genmujmuj/robot-pk/inzynierka/rys1_robot_saperski_TALON.jpg

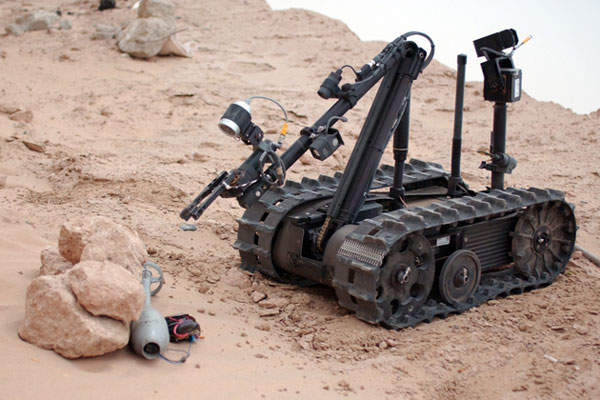
inzynierka/rys1_robot_saperski_TALON.jpg
