genmujmuj/robot-pk/inzynierka/screeny/front1.jpg

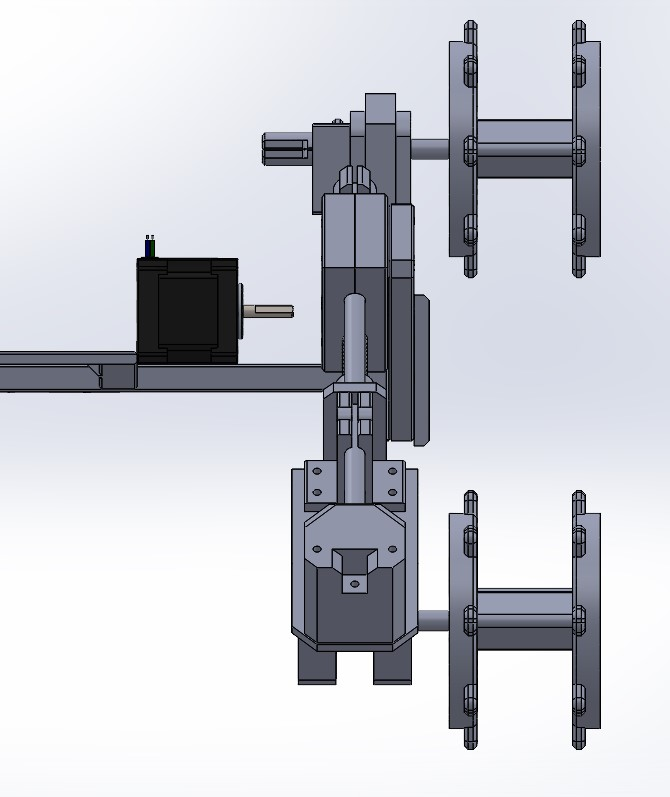
inzynierka/screeny/front1.jpg
