genmujmuj/robot-pk/inzynierka/ArduinoUNO-rys3.webp

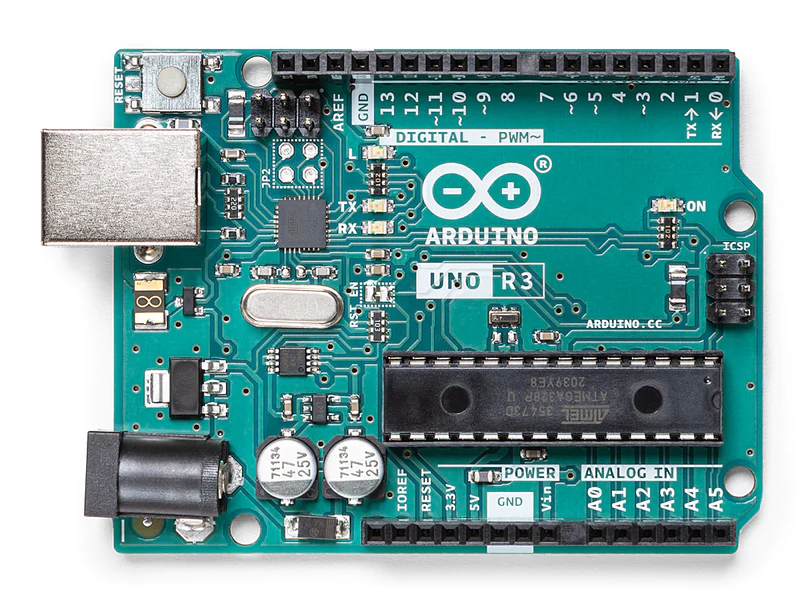
inzynierka/ArduinoUNO-rys3.webp
