genmujmuj/robot-pk/inzynierka/flysky_fs-ia6b.jpeg

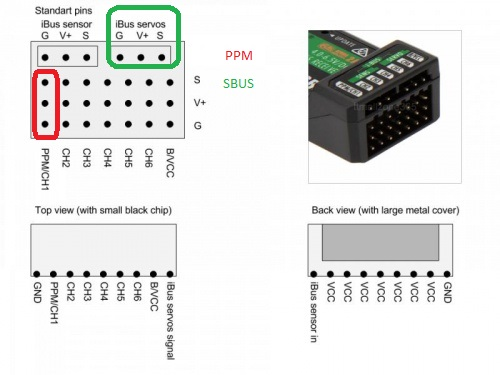
inzynierka/flysky_fs-ia6b.jpeg
