genmujmuj/robot-pk/inzynierka/pp_1.jpg

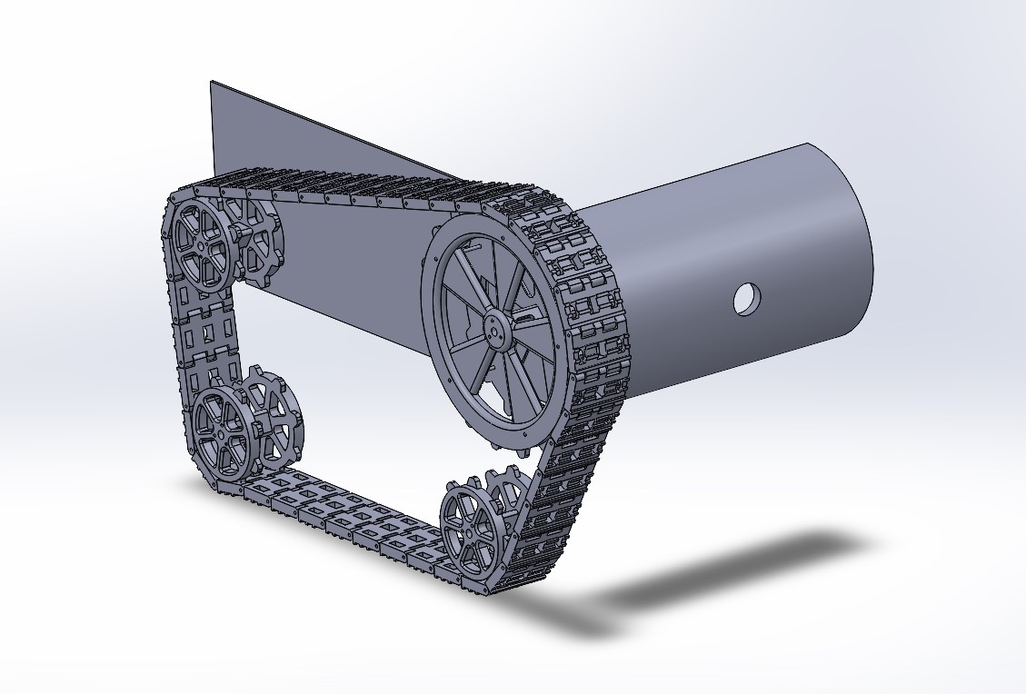
inzynierka/pp_1.jpg
