genmujmuj/robot-pk/inzynierka/pp_2.jpg

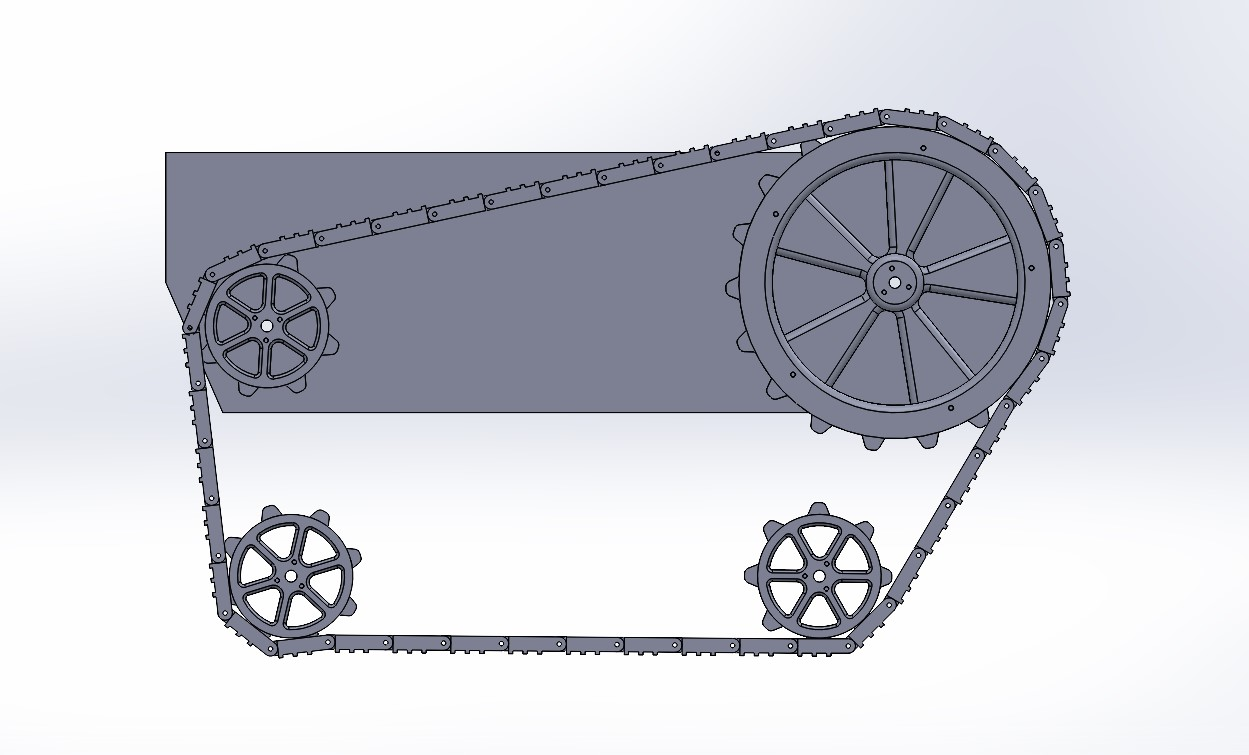
inzynierka/pp_2.jpg
