genmujmuj/robot-pk/inzynierka/rys_schemat_logiczny_układu.png

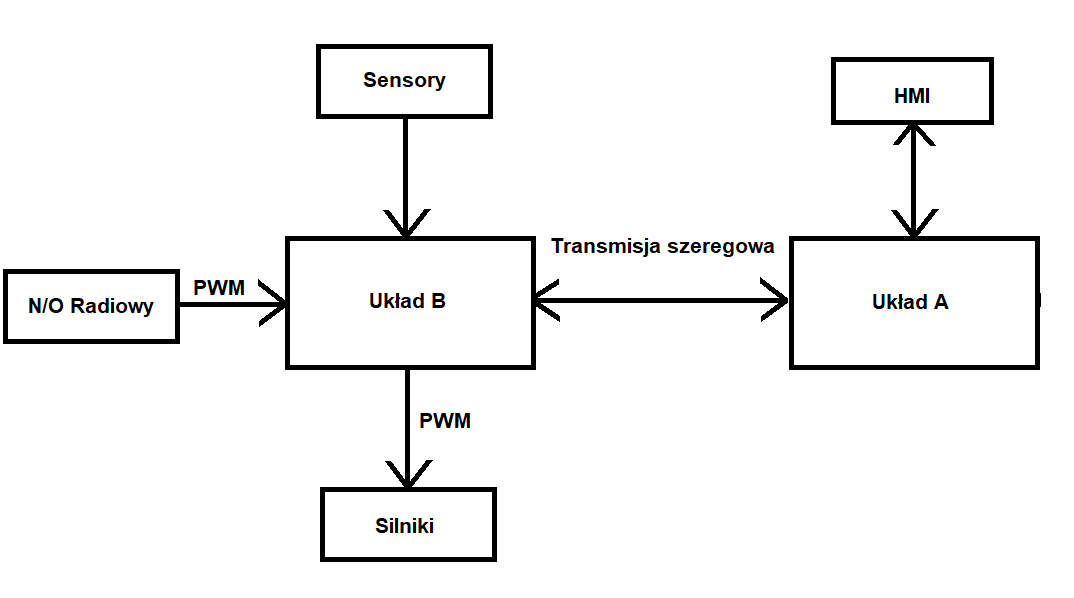
inzynierka/rys_schemat_logiczny_układu.png
