genmujmuj/robot-pk/inzynierka/screeny/bok1.jpg

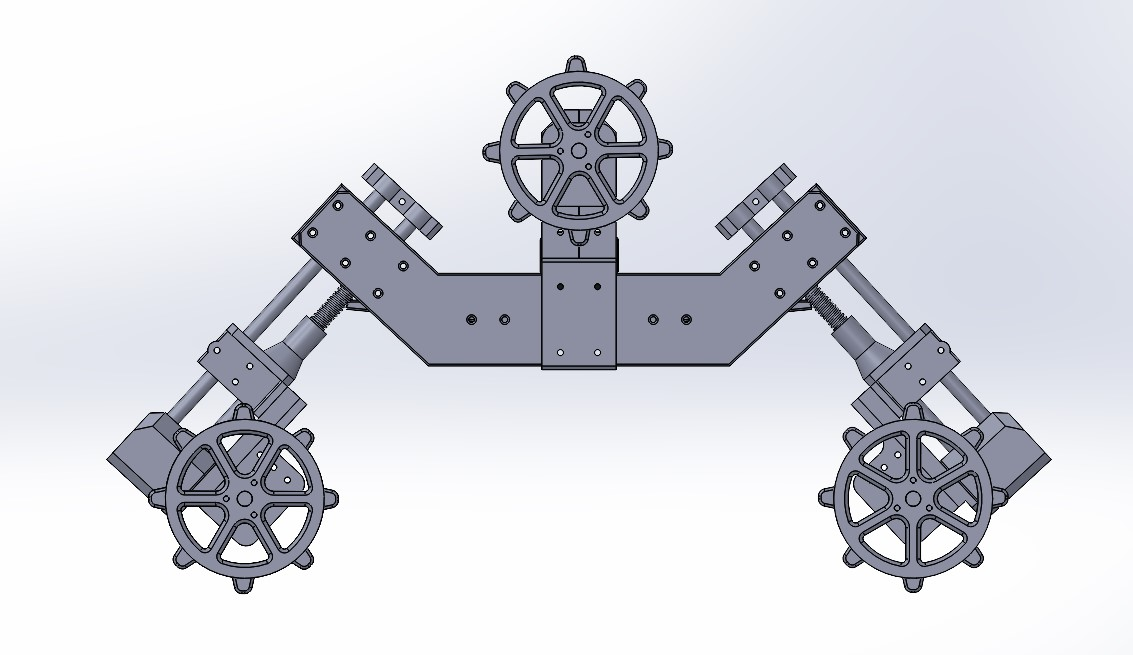
inzynierka/screeny/bok1.jpg
