genmujmuj/robot-pk/inzynierka/screeny/bok2.jpg

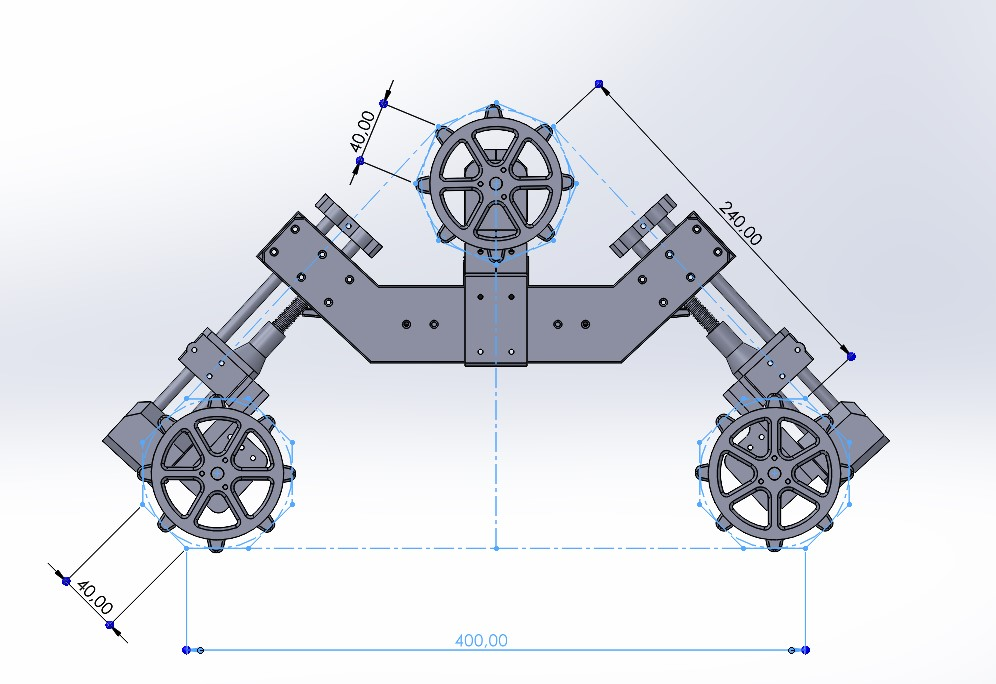
inzynierka/screeny/bok2.jpg
