genmujmuj/robot-pk/inzynierka/screeny/front2.jpg

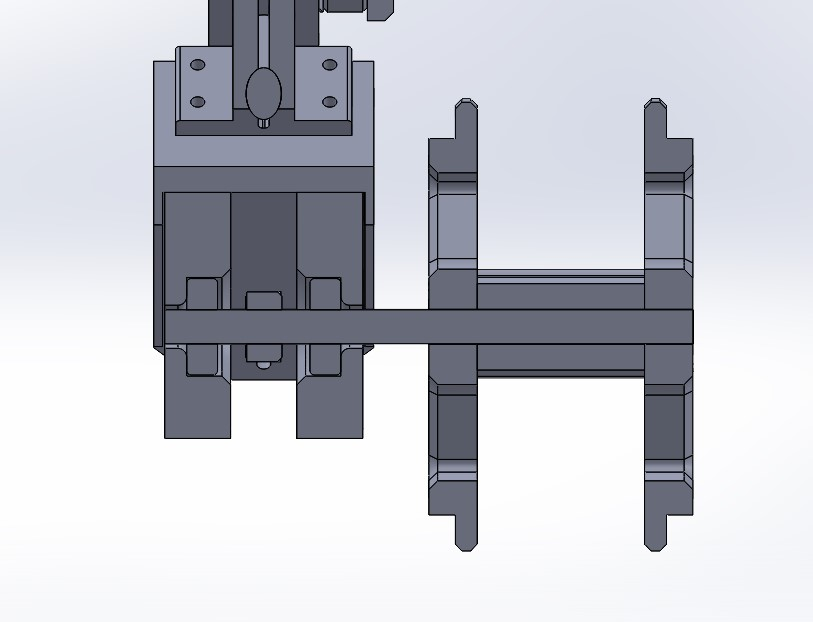
inzynierka/screeny/front2.jpg
