genmujmuj/robot-pk/inzynierka/screeny/góra1.jpg

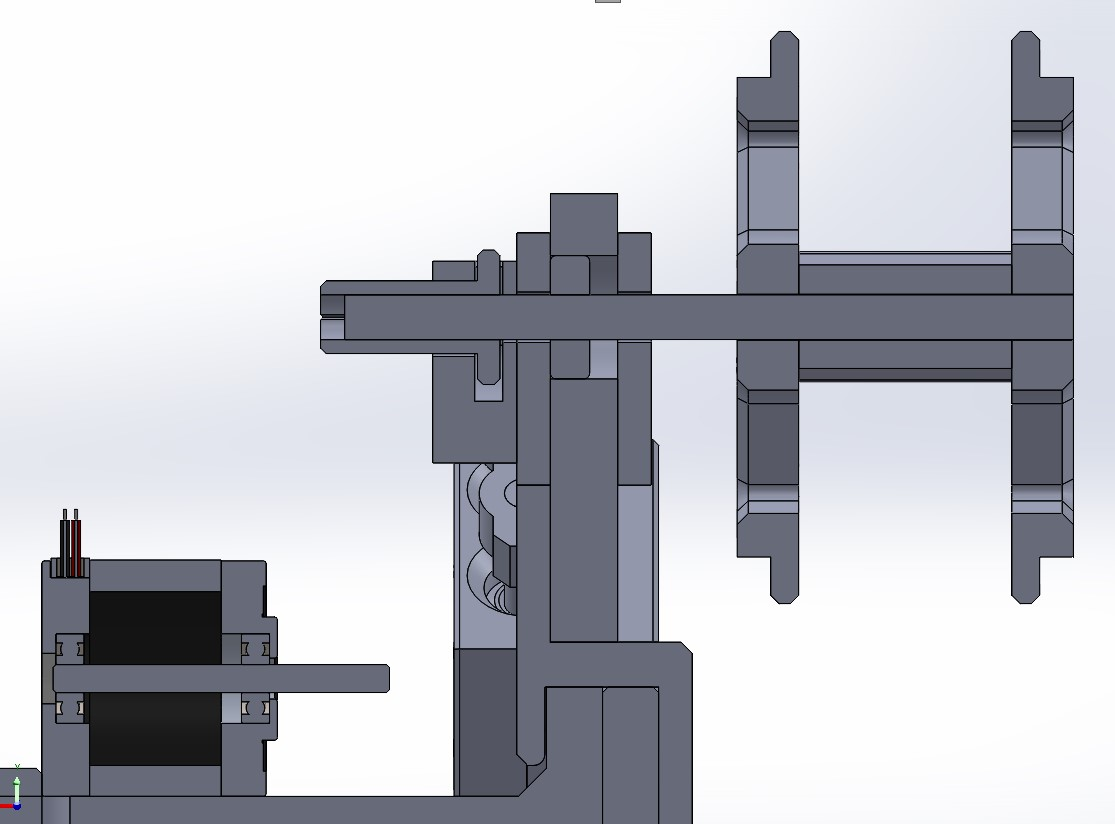
inzynierka/screeny/góra1.jpg
