genmujmuj/robot-pk/inzynierka/screeny/izo1.jpg

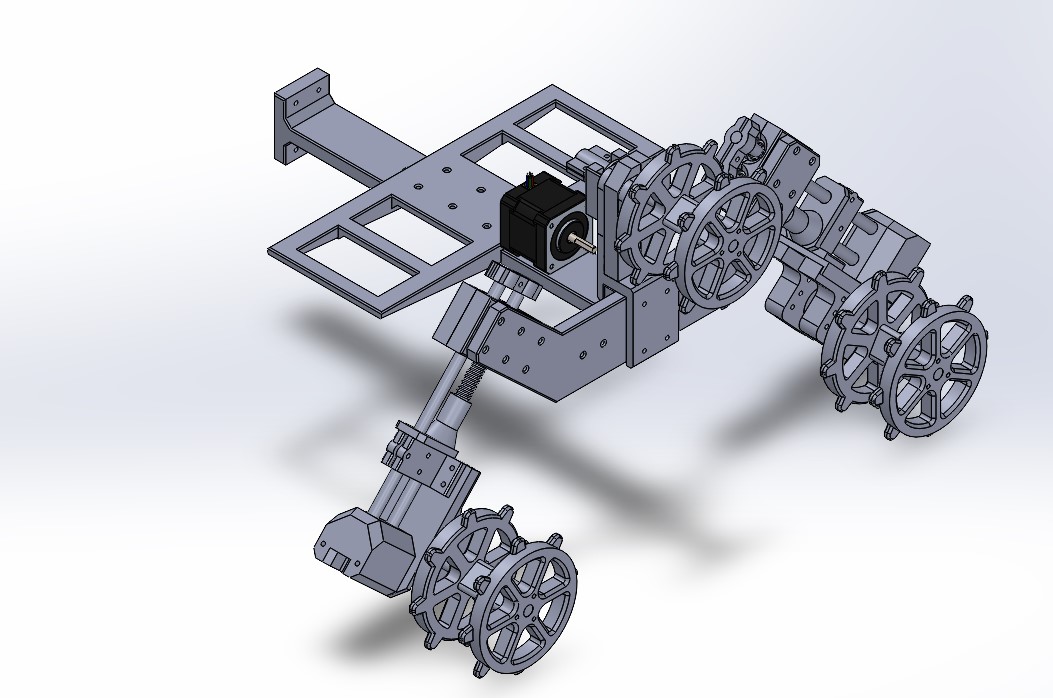
inzynierka/screeny/izo1.jpg
