genmujmuj/robot-pk/inzynierka/screeny/izo2.jpg

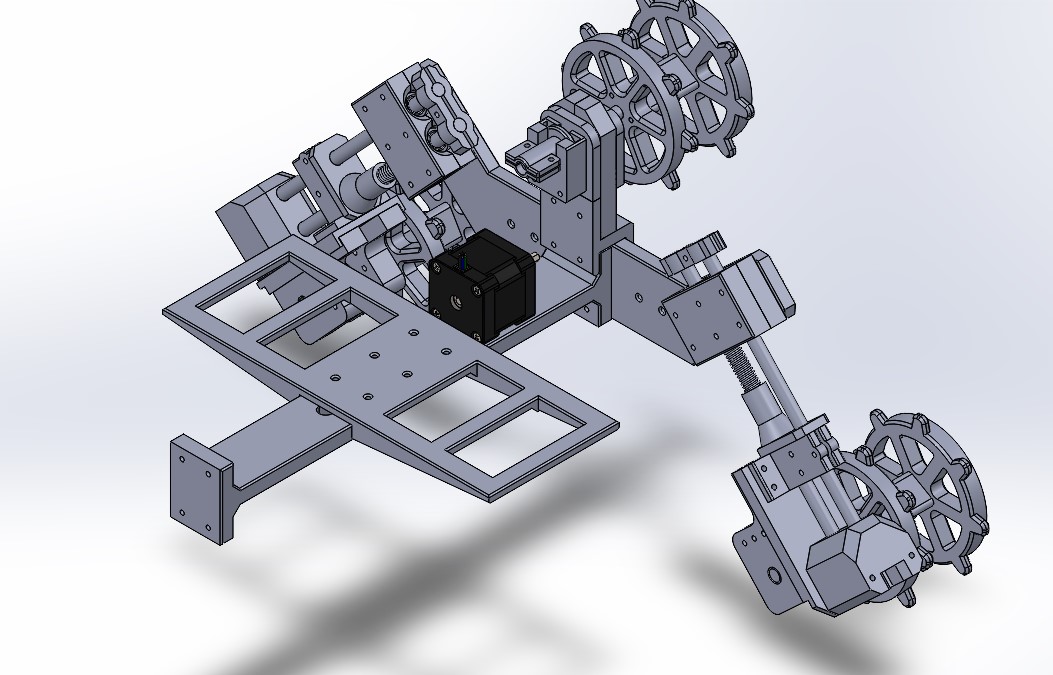
inzynierka/screeny/izo2.jpg
