genmujmuj/robot-pk/1.pdf

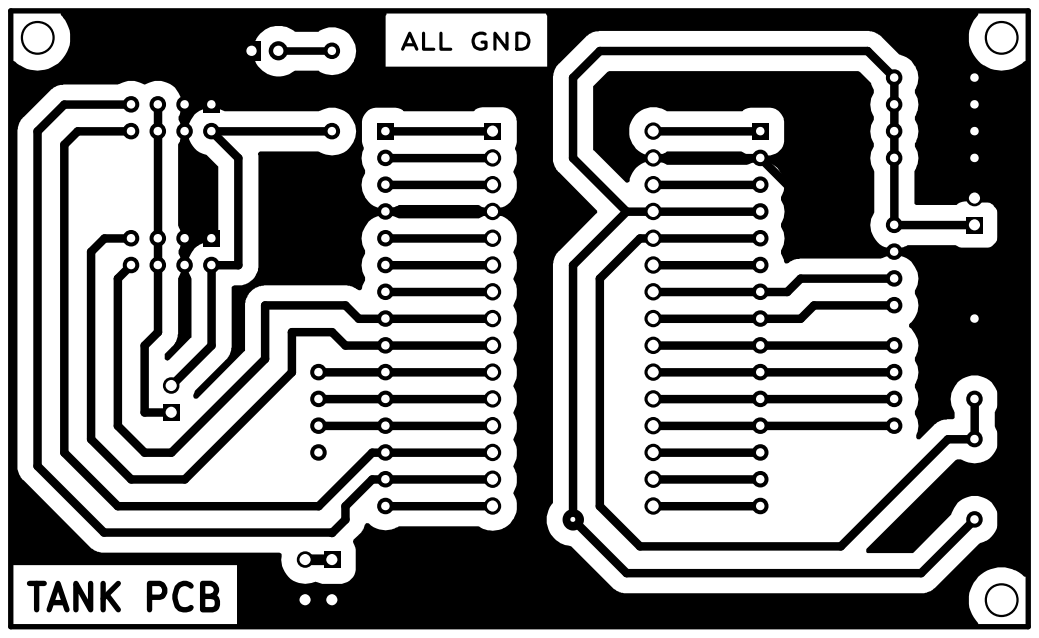
[picture p30: page 1]
