genmujmuj/robot-pk/2.pdf

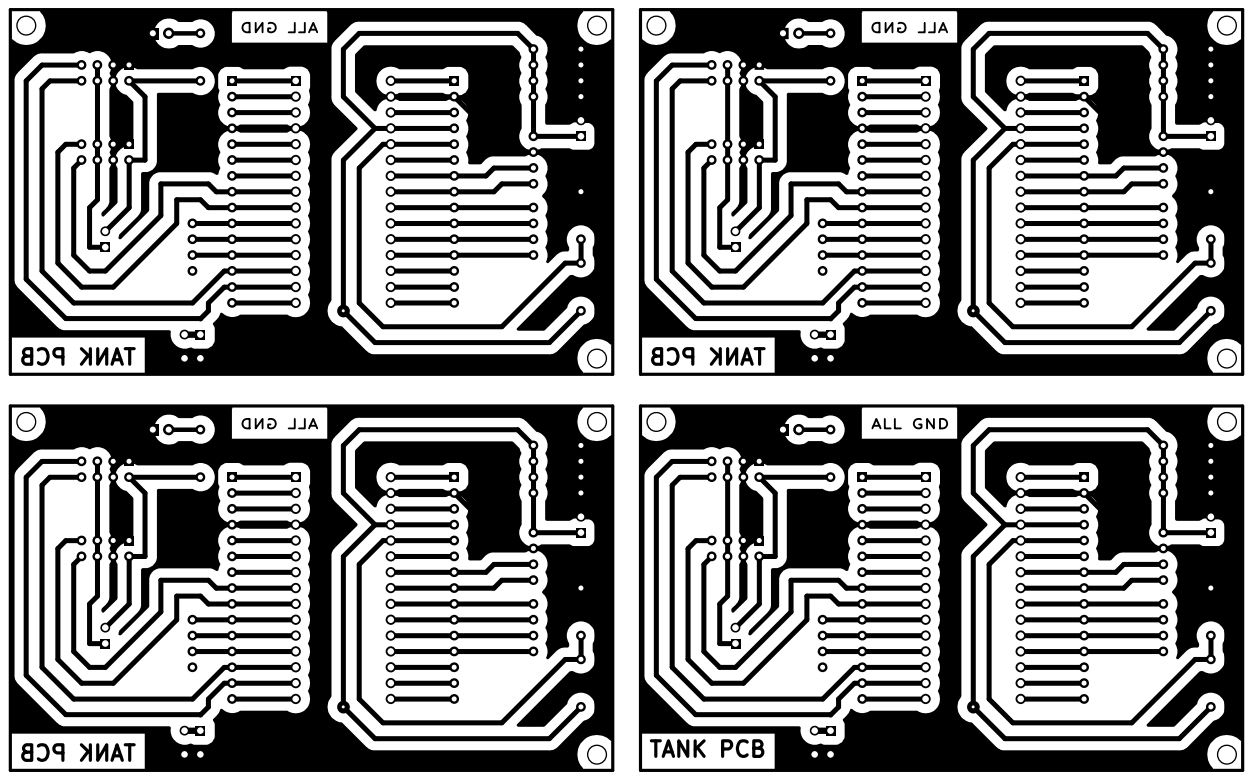
[picture p31: page 1]
