genmujmuj/robot-pk/inzynierka/załącznik_Schemat_elektryczny.pdf

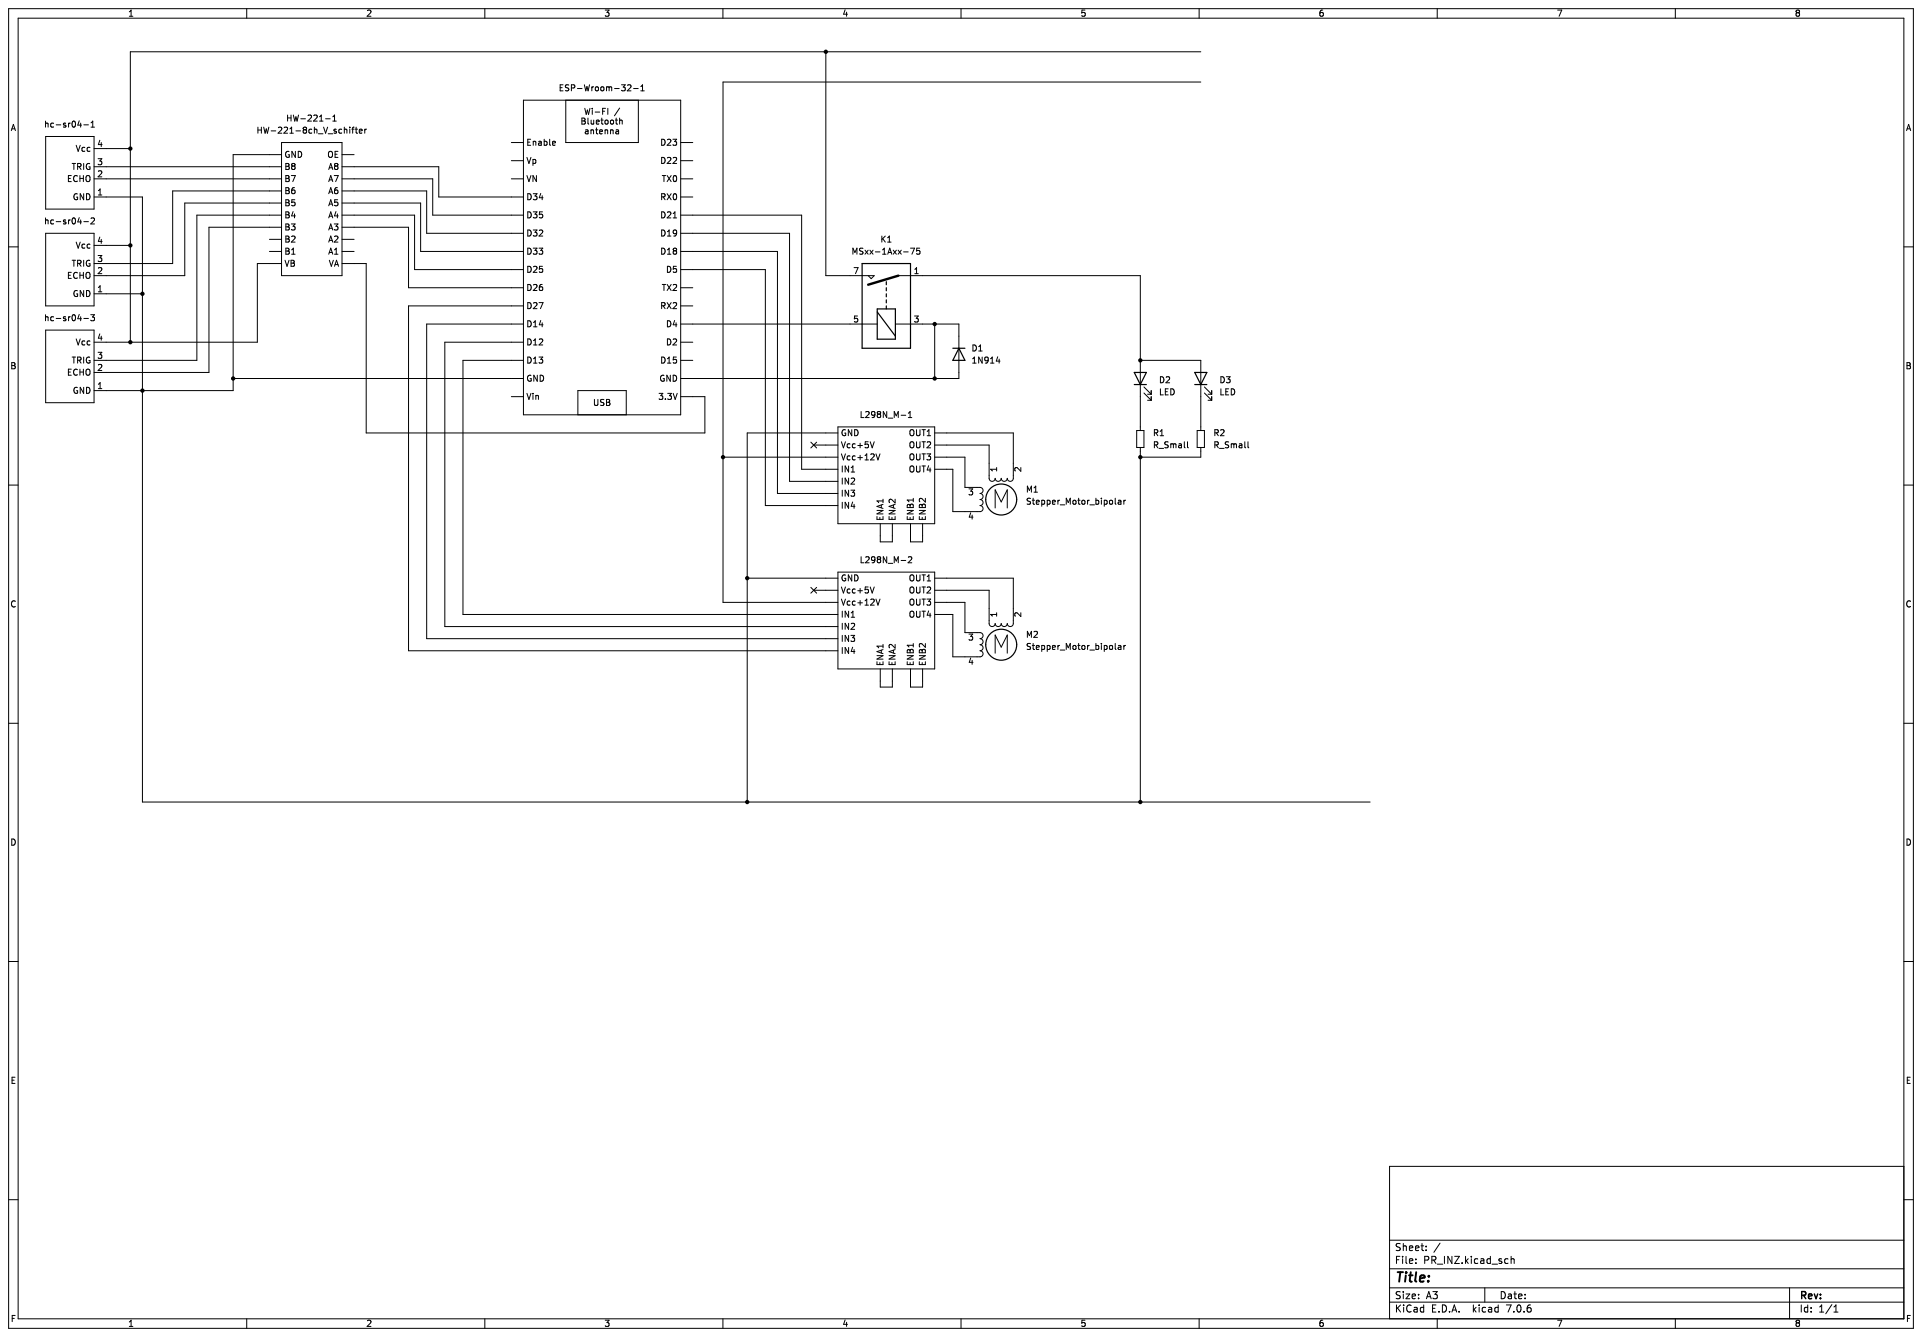
[picture p32: page 1]
