genmujmuj/robot-pk/PR_INZ.kicad_pcb

## KiCad design mvps/mvps.kicad_sch

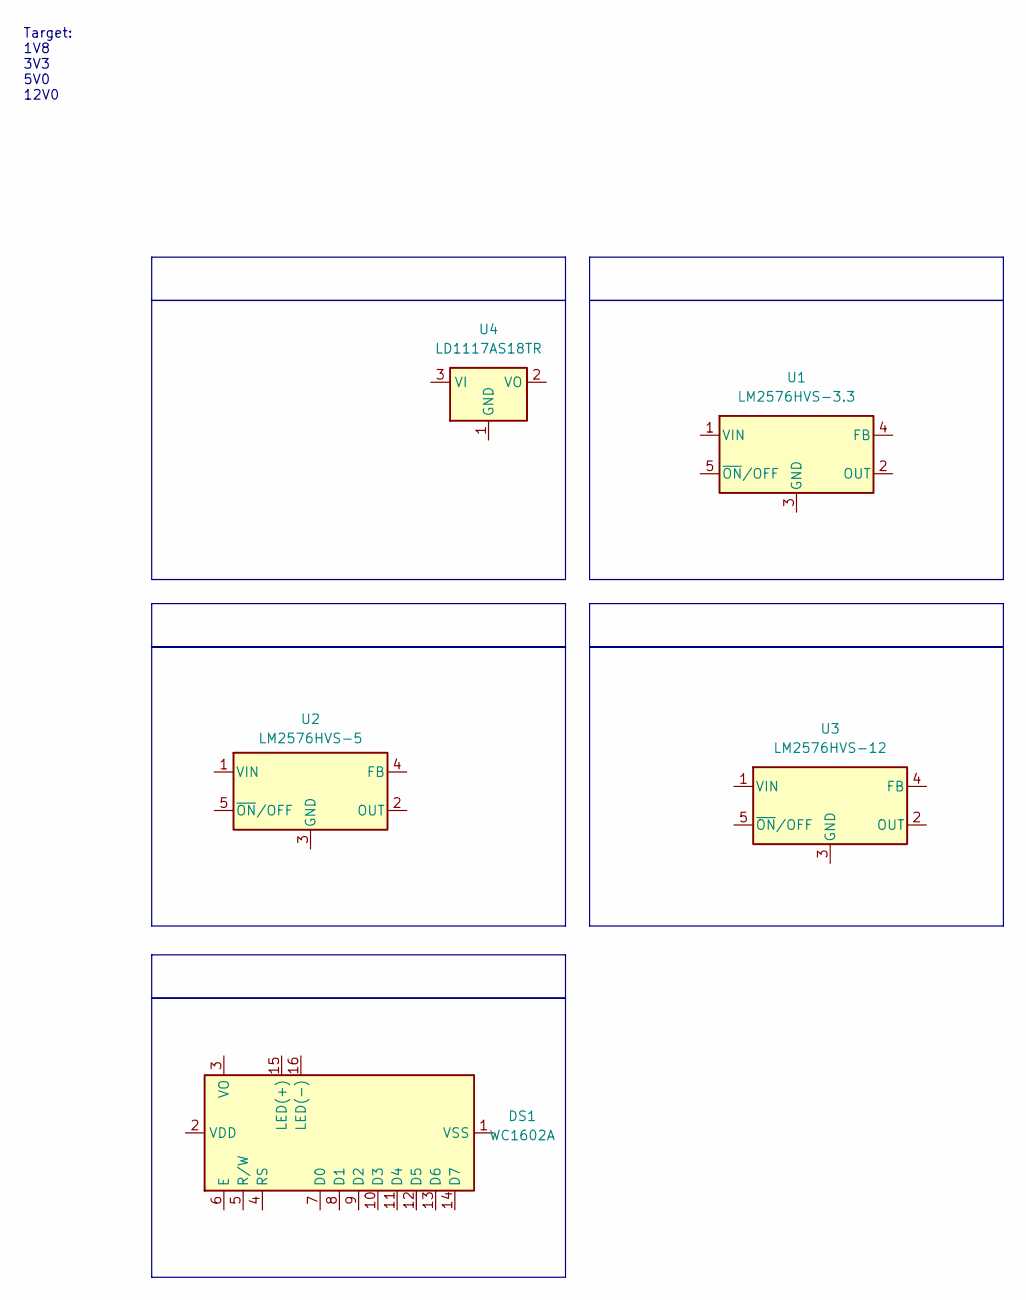
[picture p33: schematic mvps.kicad_sch]

Parts:
DS1: WC1602A
U1: LM2576HVS-3.3; TO-263-5_TabPin3
U2: LM2576HVS-5; TO-263-5_TabPin3
U3: LM2576HVS-12; TO-263-5_TabPin3
U4: LD1117AS18TR; SOT-223-3_TabPin2

Notes on the sheet:
Target: 1V8 3V3 5V0 12V0
