genmujmuj/robot-pk/(commit log)

2024-08-04 first upload
    [PR_INZ.kicad_pcb, PR_INZ.kicad_sch]
2024-08-04 drugi commit - pliki pracy
    [obliczenia do gąsienic.ods, załącznik_Pomiar_prądu_FS-iA6B.xlsx]
2024-08-15 PCB update
